michaellangford99/STM32_SMD_Quadcopter_PCB/Requirements.xlsx

Mounting holes, 4 corners
power over USB
USB FTDI communication
DSMX either solder on space or connector
SD card either slot or solder-in
MPU9250
battery and indicator LEDs
Motor outputs
small, precise form factor
nothing smaller than 0603
hand solderable
extra peripherals broken out
programming header for ST-link
labelled peripherals
SMD motor pads?
all connectors at board edge
populate both sides
all tall parts on top side
battery voltage detection
communication between boards
radio, eventually onboard
servo outputs
camera input
gps connector
all bottom components easy to solder, simple
or just keep bottom blank and extend board size
actually if we just minimize parts on opposite side to only regulators and caps we can do ourselves that's fine
Keep difficult parts on top such as FT230XQ, put already hand soldering parts on bottom like Vregs and power mosfets
also could put level shifters on bottom as well. Also just use v dividers for CS and SCK?
add a crap ton of 1206 caps of various capacity to bottom of board later
as many as possible are simple
using ICM20948 because MPU6050 has no SPI bus
level shifter IC in use is merely N-channel MOSFET with sufficiently low Gate threshold voltage
switched crystal to 16MHz oscillator referenced in video
Use MPU6050? If it's in stock we might as well deal with lack of SPI bus. Depends on difficulty of I2c implementation.
I2C is 3 wire which works to our advantage. Removes need for Level shifting circuitry and 1.8V parts
parts not in database at all:
ICM20948
tactile reset switch (unless we use an extended part)
SD card connector
USB connector
motor control MOSFET
all connectors
parts not basic:
STM32F446RET6
FT230XQ
1.8V regulator
attempt to group bottom and top motor control outputs together to prevent voltage drop on traces and leave room on right side for digital traces
trying to hook up additional pininto SWD but not sure where it goes yet lol
you will on the next board need to abandon the 1x1.5" form factor to allow for mounting holes and ESC connector blocks
eliminate electrolytic from SMD parts because JLC doesn't have that footprint type in any form factor as basic part.
Also through a but ton of 1210 caps on the bottom of the board so it lies flat
eliminate 10v+ ESD diodes from SMD parts because they don't have any 0805 or similar form factor. Consider switching to a DPAK
next switch over to more commonly used STM32F4
HINT: downloaded script to generate JLCPCB BOM from github. https://github.com/wokwi/kicad-jlcpcb-bom-plugin
change LCSC to LCSC Part # ?
apparently they have neither the FT230XQ nor the STM32F446RET6 in stock… so….
watch out for position/rotation errors
select 'selected location' for JLC part number
I’ll buy current board because I still have parts
next one will be with different MCU and USB chip (maybe)
ESC control circuit for later :PCA9685PW
