michaellangford99/STM32_SMD_Quadcopter_PCB/(list of files, drawings)

Other design files:
en.nucleo_64pins_sch/MB1136C_schematic_layout/Connectors.SchDoc
en.nucleo_64pins_sch/MB1136C_schematic_layout/MB1136.PcbDoc
en.nucleo_64pins_sch/MB1136C_schematic_layout/MB1136.PrjPCB
en.nucleo_64pins_sch/MB1136C_schematic_layout/MB1136.SchDoc
en.nucleo_64pins_sch/MB1136C_schematic_layout/MB1136.SCHLIB
en.nucleo_64pins_sch/MB1136C_schematic_layout/MCU_64.SchDoc
en.nucleo_64pins_sch/MB1136C_schematic_layout/ST_LINK_V2-1.SCHDOC
