michaellangford99/STM32_SMD_Quadcopter_PCB/STM32_SMD_Quadcopter/STM32_SMD_Quadcopter.kicad_pcb

## KiCad design STM32_SMD_Quadcopter/STM32_SMD_Quadcopter.kicad_pcb (2021-03-11)

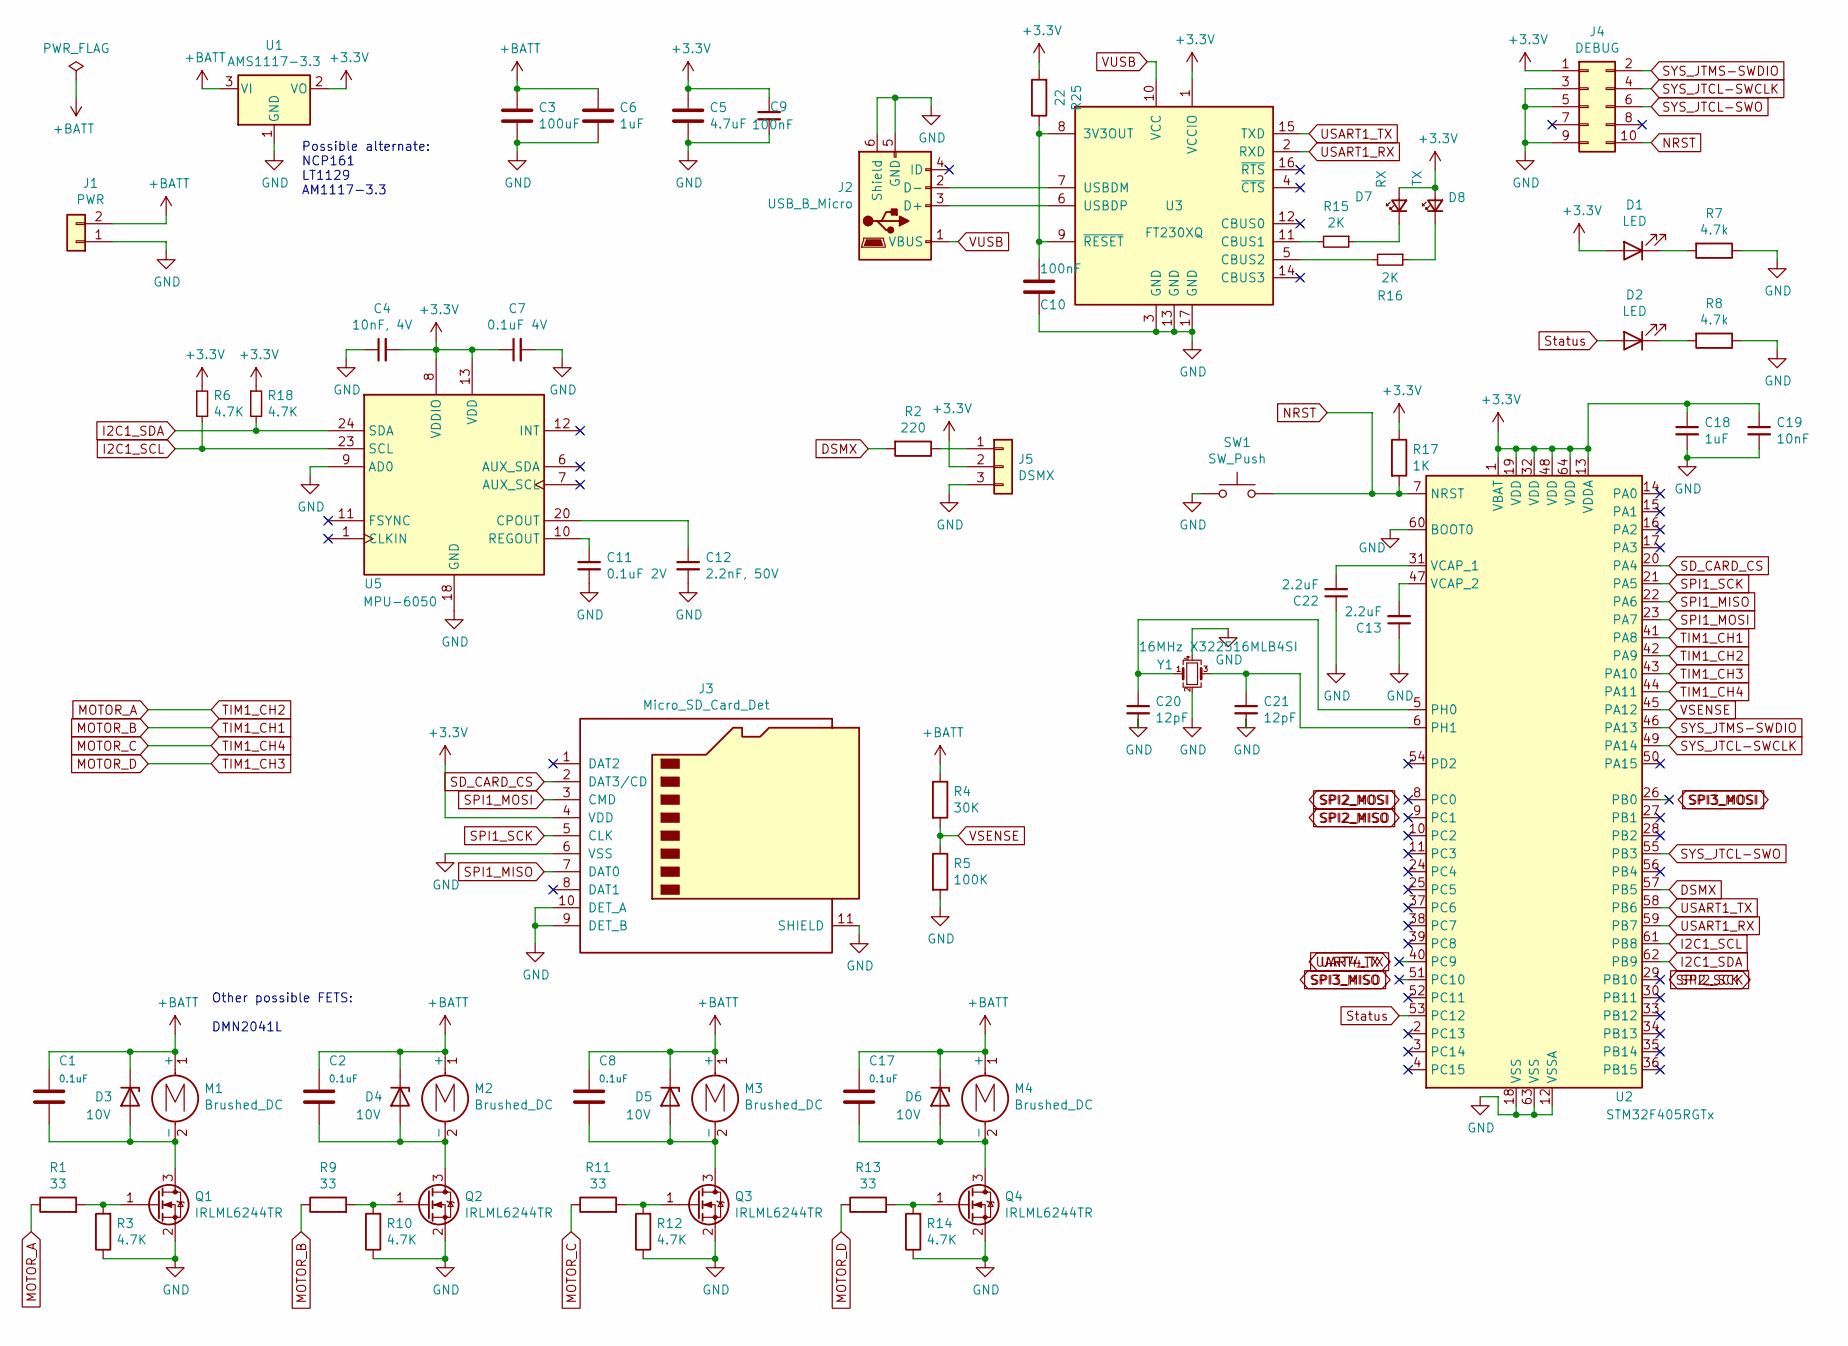
[picture p1: schematic STM32_SMD_Quadcopter.sch]

Parts:
C1, C2, C8, C17: 0.1uF; C_0402_1005Metric; LCSC Part # C1525
C3: 100uF; C_Elec_3x5.4; JLCPCB BOM 0
C4: 10nF, 4V; C_0402_1005Metric; LCSC Part # C15195
C5: 4.7uF; C_1210_3225Metric; JLCPCB BOM 0
C6, C18: 1uF; C_0603_1608Metric; LCSC Part # C15849
C7: 0.1uF 4V; C_0402_1005Metric; LCSC Part # C1525
C9, C10: 100nF; C_0402_1005Metric; LCSC Part # C1525
C11: 0.1uF 2V; C_0402_1005Metric; LCSC Part # C1525
C12: 2.2nF, 50V; C_0805_2012Metric; LCSC Part # C28260
C13, C22: 2.2uF; C_0603_1608Metric; LCSC Part # C23630
C19: 10nF; C_0603_1608Metric; LCSC Part # C57112
C20, C21: 12pF; C_0603_1608Metric; LCSC Part # C38523
D1: LED; LED_0603_1608Metric; LCSC Part # C72038
D2: LED; LED_0603_1608Metric; LCSC Part # C72043
D3, D4, D5, D6: 10V; D_0805_2012Metric; JLCPCB BOM 0
D7: RX; LED_0603_1608Metric; LCSC Part # C72041
D8: TX; LED_0603_1608Metric; LCSC Part # C2286
J1: PWR; PinHeader_1x02_P2.54mm_Vertical; JLCPCB BOM 0
J2: USB_B_Micro; USB_Micro-B_Molex_47346-0001; JLCPCB BOM 0
J3: Micro_SD_Card_Det; microSD_HC_Hirose_DM3D-SF; JLCPCB BOM 0
J4: DEBUG; PinSocket_2x05_P1.27mm_Vertical_SMD; JLCPCB BOM 0
J5: DSMX; PinHeader_1x03_P2.54mm_Vertical; JLCPCB BOM 0
M1, M2, M3, M4: Brushed_DC; PinHeader_1x02_P2.00mm_Vertical; JLCPCB BOM 0
Q1, Q2, Q3, Q4: IRLML6244TR; SOT-23_Handsoldering; JLCPCB BOM 0
R1, R9, R11, R13: 33; R_0603_1608Metric; LCSC Part # C23140
R2: 220; R_0603_1608Metric; LCSC Part # C22962
R3, R6, R10, R12, R14, R18: 4.7K; R_0603_1608Metric; LCSC Part # C23162
R4: 30K; R_0603_1608Metric; LCSC Part # C22984
R5: 100K; R_0603_1608Metric; LCSC Part # C25803
R7, R8: 4.7k; R_0603_1608Metric; LCSC Part # C23162
R15, R16: 2K; R_0603_1608Metric; LCSC Part # C22975
R17: 1K; R_0603_1608Metric; LCSC Part # C21190
R25: 22; R_0402_1005Metric; LCSC Part # C25092
SW1: SW_Push; SW_SPST_B3U-1000P; JLCPCB BOM 0
U1: AMS1117-3.3; SOT-223-3_TabPin2; JLCPCB BOM 0
U2: STM32F405RGTx; LQFP-64_10x10mm_P0.5mm
U3: FT230XQ; QFN-16-1EP_4x4mm_P0.65mm_EP2.5x2.5mm; LCSC Part # C128629
U5: MPU-6050; InvenSense_QFN-24_4x4mm_P0.5mm; LCSC Part # C24112
Y1: 16MHz X322516MLB4SI; Crystal_SMD_3225-4Pin_3.2x2.5mm; LCSC Part # C13738

Connections:
+3V3: C4.2, C5.1, C7.1, C9.1, C18.1, C19.1, D1.2 (A), D7.2 (A), D8.2 (A), J3.4 (VDD), J4.1, J5.2, R6.1, R17.1, R18.1, R25.2, U1.2 (VO), U2.1 (VBAT), U2.13 (VDDA), U2.19 (VDD), U2.32 (VDD), U2.48 (VDD), U2.64 (VDD), U3.1 (VCCIO), U5.8 (VDDIO), U5.13 (VDD); also elsewhere on the board
+BATT: C1.1, C2.1, C3.1, C6.1, C8.1, C17.1, D3.1 (K), D4.1 (K), D5.1 (K), D6.1 (K), J1.2, M1.1 (+), M2.1 (+), M3.1 (+), M4.1 (+), R4.1, U1.3 (VI)
DSMX: R2.2, U2.57 (PB5); also elsewhere on the board
I2C1_SCL: R6.2, U2.61 (PB8), U5.23 (SCL); also elsewhere on the board
I2C1_SDA: R18.2, U2.62 (PB9), U5.24 (SDA); also elsewhere on the board
MOTOR_A: R1.1, U2.42 (PA9); also elsewhere on the board
MOTOR_B: R9.1, U2.41 (PA8); also elsewhere on the board
MOTOR_C: R11.1, U2.44 (PA11); also elsewhere on the board
MOTOR_D: R13.1, U2.43 (PA10); also elsewhere on the board
NRST: J4.10, R17.2, SW1.2, U2.7 (NRST); also elsewhere on the board
unnamed: C1.2, D3.2 (A), M1.2 (-), Q1.3 (D)
unnamed: C2.2, D4.2 (A), M2.2 (-), Q2.3 (D)
unnamed: C8.2, D5.2 (A), M3.2 (-), Q3.3 (D)
unnamed: C10.2, R25.1, U3.8 (3V3OUT), U3.9 (~RESET)
unnamed: C11.1, U5.10 (REGOUT)
unnamed: C12.1, U5.20 (CPOUT)
unnamed: C13.2, U2.47 (VCAP_2)
unnamed: C17.2, D6.2 (A), M4.2 (-), Q4.3 (D)
unnamed 18: C20.1, U2.5 (PH0), Y1.1; also elsewhere on the board
unnamed 19: C21.1, U2.6 (PH1), Y1.3; also elsewhere on the board
unnamed: D1.1 (K), R7.2
unnamed: D2.1 (K), R8.2
unnamed: D7.1 (K), R15.1
unnamed: D8.1 (K), R16.1
unnamed: J2.2 (D-), U3.7 (USBDM)
unnamed: J2.3 (D+), U3.6 (USBDP)
unnamed: J5.1, R2.1
unnamed: Q1.1 (G), R1.2, R3.2
unnamed: Q2.1 (G), R9.2, R10.2
unnamed: Q3.1 (G), R11.2, R12.2
unnamed: Q4.1 (G), R13.2, R14.2
unnamed: R15.2, U3.11 (CBUS1)
unnamed: R16.2, U3.5 (CBUS2)
SD_CARD_CS: J3.2 (DAT3/CD), U2.20 (PA4); also elsewhere on the board
SPI1_MISO: J3.7 (DAT0), U2.22 (PA6); also elsewhere on the board
SPI1_MOSI: J3.3 (CMD), U2.23 (PA7); also elsewhere on the board
SPI1_SCK: J3.5 (CLK), U2.21 (PA5); also elsewhere on the board
SYS_JTCL-SWCLK: J4.4, U2.49 (PA14); also elsewhere on the board
SYS_JTCL-SWO: J4.6, U2.55 (PB3); also elsewhere on the board
SYS_JTMS-SWDIO: J4.2, U2.46 (PA13); also elsewhere on the board
Status: D2.2 (A), U2.53 (PC12); also elsewhere on the board
USART1_RX: U2.59 (PB7), U3.2 (RXD); also elsewhere on the board
USART1_TX: U2.58 (PB6), U3.15 (TXD); also elsewhere on the board
VSENSE: R4.2, R5.1, U2.45 (PA12); also elsewhere on the board
VUSB: J2.1 (VBUS), U3.10 (VCC)

Notes on the sheet:
Other possible FETS: DMN2041L
Possible alternate: NCP161 LT1129 AM1117-3.3

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
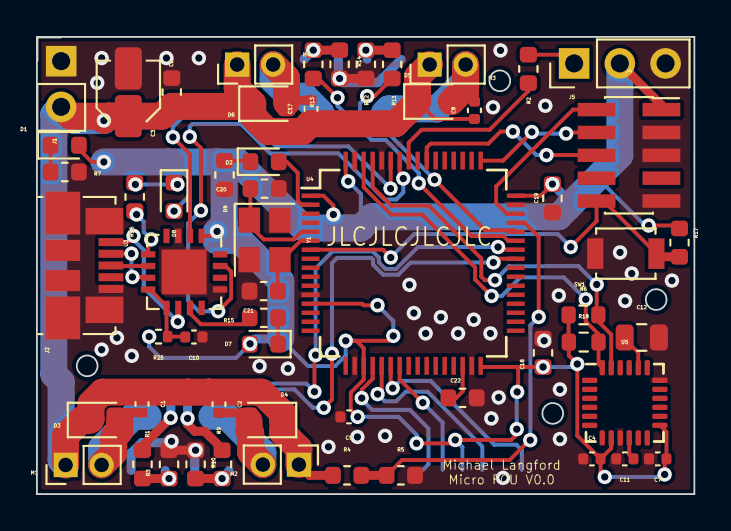
[picture p2: board STM32_SMD_Quadcopter.kicad_pcb from above]

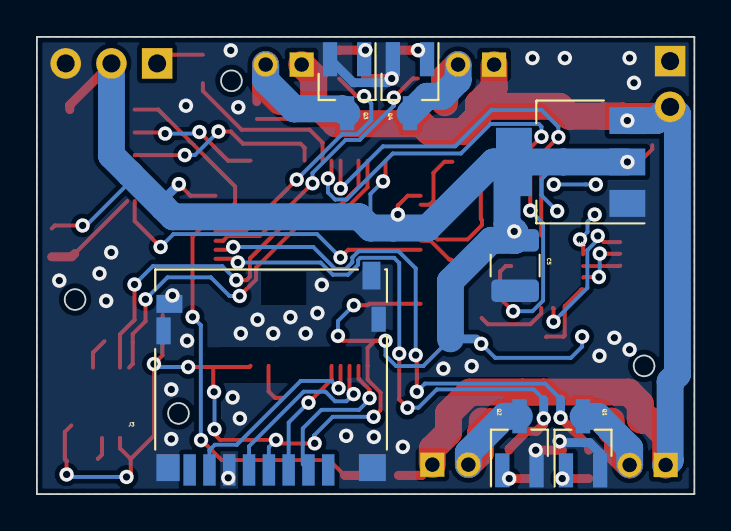
[picture p3: board STM32_SMD_Quadcopter.kicad_pcb from below]

Board: 2 copper layers, 36.5 x 25.4 mm, 64 parts (7 on the bottom side), 46 nets.

Other parts of the board:
U4: STM32F446RETx; LQFP-64_10x10mm_P0.5mm

Their connections:
+3V3: U4.1, U4.13, U4.19, U4.32, U4.48, U4.64; also elsewhere on the board
DSMX: U4.57; also elsewhere on the board
I2C1_SCL: U4.61; also elsewhere on the board
I2C1_SDA: U4.62; also elsewhere on the board
MOTOR_A: U4.42; also elsewhere on the board
MOTOR_B: U4.41; also elsewhere on the board
MOTOR_C: U4.44; also elsewhere on the board
MOTOR_D: U4.43; also elsewhere on the board
NRST: U4.7; also elsewhere on the board
unnamed 18: U4.5; also elsewhere on the board
unnamed 19: U4.6; also elsewhere on the board
SD_CARD_CS: U4.20; also elsewhere on the board
SPI1_MISO: U4.22; also elsewhere on the board
SPI1_MOSI: U4.23; also elsewhere on the board
SPI1_SCK: U4.21; also elsewhere on the board
SYS_JTCL-SWCLK: U4.49; also elsewhere on the board
SYS_JTCL-SWO: U4.55; also elsewhere on the board
SYS_JTMS-SWDIO: U4.46; also elsewhere on the board
Status: U4.2; also elsewhere on the board
USART1_RX: U4.59; also elsewhere on the board
USART1_TX: U4.58; also elsewhere on the board
VSENSE: U4.45; also elsewhere on the board
