michaellangford99/STM32_SMD_Quadcopter_PCB/(commit log)

2020-04-13 regulator, power over USB, compact SMD, 0603 min cap size
    [STM32_SMD_Quadcopter.kicad_pcb, STM32_SMD_Quadcopter.sch, _saved_STM32_SMD_Quadcopter.sch]
2020-04-14 Latest model, no traces, old crystal
    [STM32_SMD_Quadcopter.kicad_pcb, STM32_SMD_Quadcopter.sch, _saved_STM32_SMD_Quadcopter.sch]
2020-04-16 Made much denser, added traces
    [STM32_SMD_Quadcopter.kicad_pcb, STM32_SMD_Quadcopter.sch]
2020-04-16 Completed board v1
    [STM32_SMD_Quadcopter.kicad_pcb, STM32_SMD_Quadcopter.sch]
2020-04-16 Completed board v1 and added files
    [Requirements.xlsx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]
2020-04-17 fixed silkscreen
    [STM32_SMD_Quadcopter.kicad_pcb]
2020-04-20 Finished gerbers
    [STM32_SMD_Quadcopter-B_Adhes.gbr, STM32_SMD_Quadcopter-B_Cu.gbr, STM32_SMD_Quadcopter-B_Mask.gbr, STM32_SMD_Quadcopter-B_Paste.gbr, STM32_SMD_Quadcopter-B_SilkS.gbr, STM32_SMD_Quadcopter-Edge_Cuts.gbr, STM32_SMD_Quadcopter-F_Adhes.gbr, STM32_SMD_Quadcopter-F_Cu.gbr]
2020-11-25 Latest update
    [Requirements.xlsx]
2020-11-27 V2 started, using different crystal, ICM20948, 10 pin SWD header, and multiple component swaps
    [Requirements.xlsx, STM32_SMD_Quadcopter.sch]
2020-11-27 All parts set in place
    [STM32_SMD_Quadcopter.kicad_pcb, STM32_SMD_Quadcopter.sch]
2020-11-28 completed switchover to MPU6050
    [STM32_SMD_Quadcopter.kicad_pcb, STM32_SMD_Quadcopter.sch]
2020-11-28 Finished and almost ready for purchase, with stm32f446RET6 and FT230XQ
    [STM32_SMD_Quadcopter-BOM.csv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]
2021-03-11 Purchase version
    [Requirements.xlsx, STM32_SMD_Quadcopter-Footprint-Position.csv, STM32_SMD_Quadcopter.kicad_pcb, STM32_SMD_Quadcopter.sch]
